zinziroge/ft601_evaboard/ft601_module.kicad_pcb

## KiCad design ft601_module.kicad_pcb (2026-03-01)

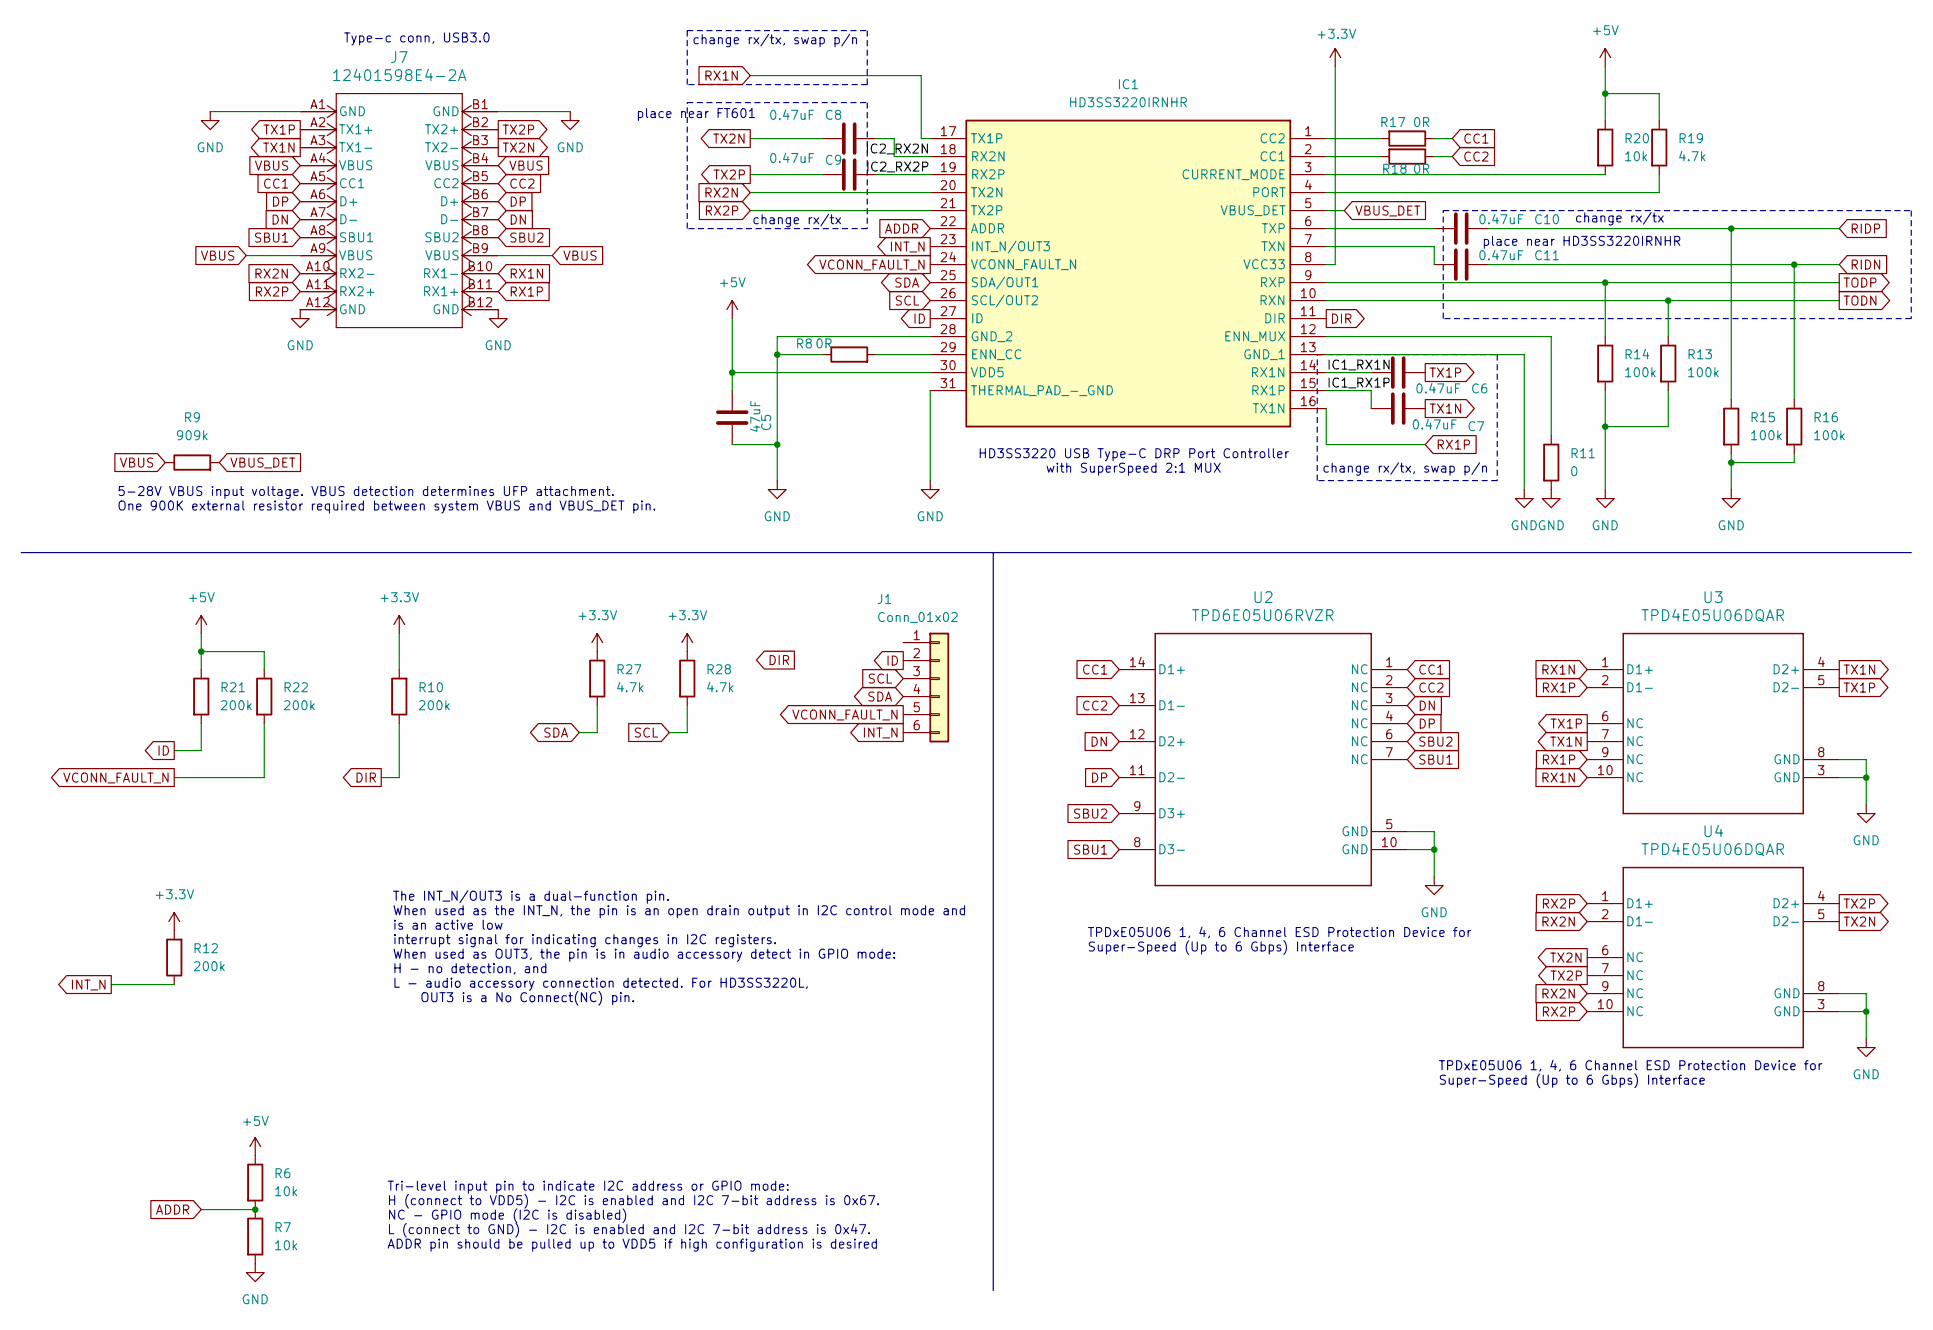
[picture p1: schematic usb3.0.kicad_sch]

Parts:
C5: 47uF; C_0603_1608Metric
C6, C7, C8, C9, C10, C11: 0.47uF; C_0402_1005Metric
IC1: HD3SS3220IRNHR; Manufacturer_Part_Number HD3SS3220IRNHR; Mouser Part Number 595-HD3SS3220IRNHR
J1: Conn_01x02; PinHeader_1x06_P2.54mm_Vertical
J7: 12401598E4-2A; CONN_12401598E4-2A_AMP
R6, R7, R20: 10k; R_0603_1608Metric
R8, R17, R18: 0R; R_0603_1608Metric
R9: 909k; R_0603_1608Metric
R10, R12, R21, R22: 200k; R_0603_1608Metric
R11: 0; R_0603_1608Metric
R13, R14, R15, R16: 100k; R_0603_1608Metric
R19, R27, R28: 4.7k; R_0603_1608Metric
U2: TPD6E05U06RVZR; RVZ0014A
U3, U4: TPD4E05U06DQAR; DQA0010A

Connections:
+3.3V: IC1.8 (VCC33), R10.2, R12.2, R27.1, R28.1; also elsewhere on the board
+5V: C5.1, IC1.30 (VDD5), R6.1, R19.1, R20.1, R21.1, R22.1; also elsewhere on the board
/usb3.0/IC1_RX1N: C6.2, IC1.14 (RX1N)
/usb3.0/IC1_RX1P: C7.2, IC1.15 (RX1P)
/usb3.0/IC2_RX2N: C8.1, IC1.18 (RX2N)
/usb3.0/IC2_RX2P: C9.1, IC1.19 (RX2P)
ADDR: IC1.22 (ADDR), R6.2, R7.1
CC1: J7.A5 (CC1), R17.1, U2.1 (NC), U2.14 (D1+)
CC2: J7.B5 (CC2), R18.1, U2.2 (NC), U2.13 (D1-)
DIR: IC1.11 (DIR), R10.1
DN: J7.A7 (D-), J7.B7 (D-), U2.3 (NC), U2.12 (D2+); also elsewhere on the board
DP: J7.A6 (D+), J7.B6 (D+), U2.4 (NC), U2.11 (D2-); also elsewhere on the board
GND: C5.2, IC1.13 (GND_1), IC1.28 (GND_2), IC1.31 (THERMAL_PAD_-_GND), J7.A1 (GND), J7.A12 (GND), J7.B1 (GND), J7.B12 (GND), R7.2, R8.1, R11.2, R13.2, R14.2, R15.2, R16.2, U2.5 (GND), U2.10 (GND), U3.3 (GND), U3.8 (GND), U4.3 (GND), U4.8 (GND); also elsewhere on the board
ID: IC1.27 (ID), J1.2, R21.2
INT_N: IC1.23 (INT_N/OUT3), J1.6, R12.1
unnamed: IC1.2 (CC1), R18.2
unnamed: IC1.1 (CC2), R17.2
unnamed: IC1.3 (CURRENT_MODE), R20.2
unnamed: IC1.29 (ENN_CC), R8.2
unnamed: IC1.12 (ENN_MUX), R11.1
unnamed: IC1.4 (PORT), R19.2
unnamed: C11.2, IC1.7 (TXN)
unnamed: C10.2, IC1.6 (TXP)
RIDN: C11.1, R16.1; also elsewhere on the board
RIDP: C10.1, R15.1; also elsewhere on the board
RX1N: IC1.17 (TX1P), J7.B10 (RX1-), U3.1 (D1+), U3.10 (NC)
RX1P: IC1.16 (TX1N), J7.B11 (RX1+), U3.2 (D1-), U3.9 (NC)
RX2N: IC1.20 (TX2N), J7.A10 (RX2-), U4.2 (D1-), U4.9 (NC)
RX2P: IC1.21 (TX2P), J7.A11 (RX2+), U4.1 (D1+), U4.10 (NC)
SBU1: J7.A8 (SBU1), U2.7 (NC), U2.8 (D3-)
SBU2: J7.B8 (SBU2), U2.6 (NC), U2.9 (D3+)
SCL: IC1.26 (SCL/OUT2), J1.3, R28.2
SDA: IC1.25 (SDA/OUT1), J1.4, R27.2
TODN: IC1.10 (RXN), R13.1; also elsewhere on the board
TODP: IC1.9 (RXP), R14.1; also elsewhere on the board
TX1N: C7.1, J7.A3 (TX1-), U3.4 (D2+), U3.7 (NC)
TX1P: C6.1, J7.A2 (TX1+), U3.5 (D2-), U3.6 (NC)
TX2N: C8.2, J7.B3 (TX2-), U4.5 (D2-), U4.6 (NC)
TX2P: C9.2, J7.B2 (TX2+), U4.4 (D2+), U4.7 (NC)
VBUS: J7.A4 (VBUS), J7.A9 (VBUS), J7.B4 (VBUS), J7.B9 (VBUS), R9.1; also elsewhere on the board
VBUS_DET: IC1.5 (VBUS_DET), R9.2
VCONN_FAULT_N: IC1.24 (VCONN_FAULT_N), J1.5, R22.2

Notes on the sheet:
place near FT601
HD3SS3220 USB Type-C DRP Port Controller with SuperSpeed 2:1 MUX
change rx/tx, swap p/n
5-28V VBUS input voltage. VBUS detection determines UFP attachment. One 900K external resistor required between system VBUS and VBUS_DET pin.
The INT_N/OUT3 is a dual-function pin. When used as the INT_N, the pin is an open drain output in I2C control mode and is an active low interrupt signal for indicating changes in I2C registers. When used as OUT3, the pin is in audio accessory detect in GPIO mode: H - no detection, and L - audio acc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
change rx/tx
TPDxE05U06 1, 4, 6 Channel ESD Protection Device for Super-Speed (Up to 6 Gbps) Interface
Tri-level input pin to indicate I2C address or GPIO mode: H (connect to VDD5) - I2C is enabled and I2C 7-bit address is 0x67. NC - GPIO mode (I2C is disabled) L (connect to GND) - I2C is enabled and I2C 7-bit address is 0x47. ADDR pin should be pulled up to VDD5 if high configuration is desired
Type-c conn, USB3.0
place near HD3SS3220IRNHR
TPDxE05U06 1, 4, 6 Channel ESD Protection Device for Super-Speed (Up to 6 Gbps) Interface

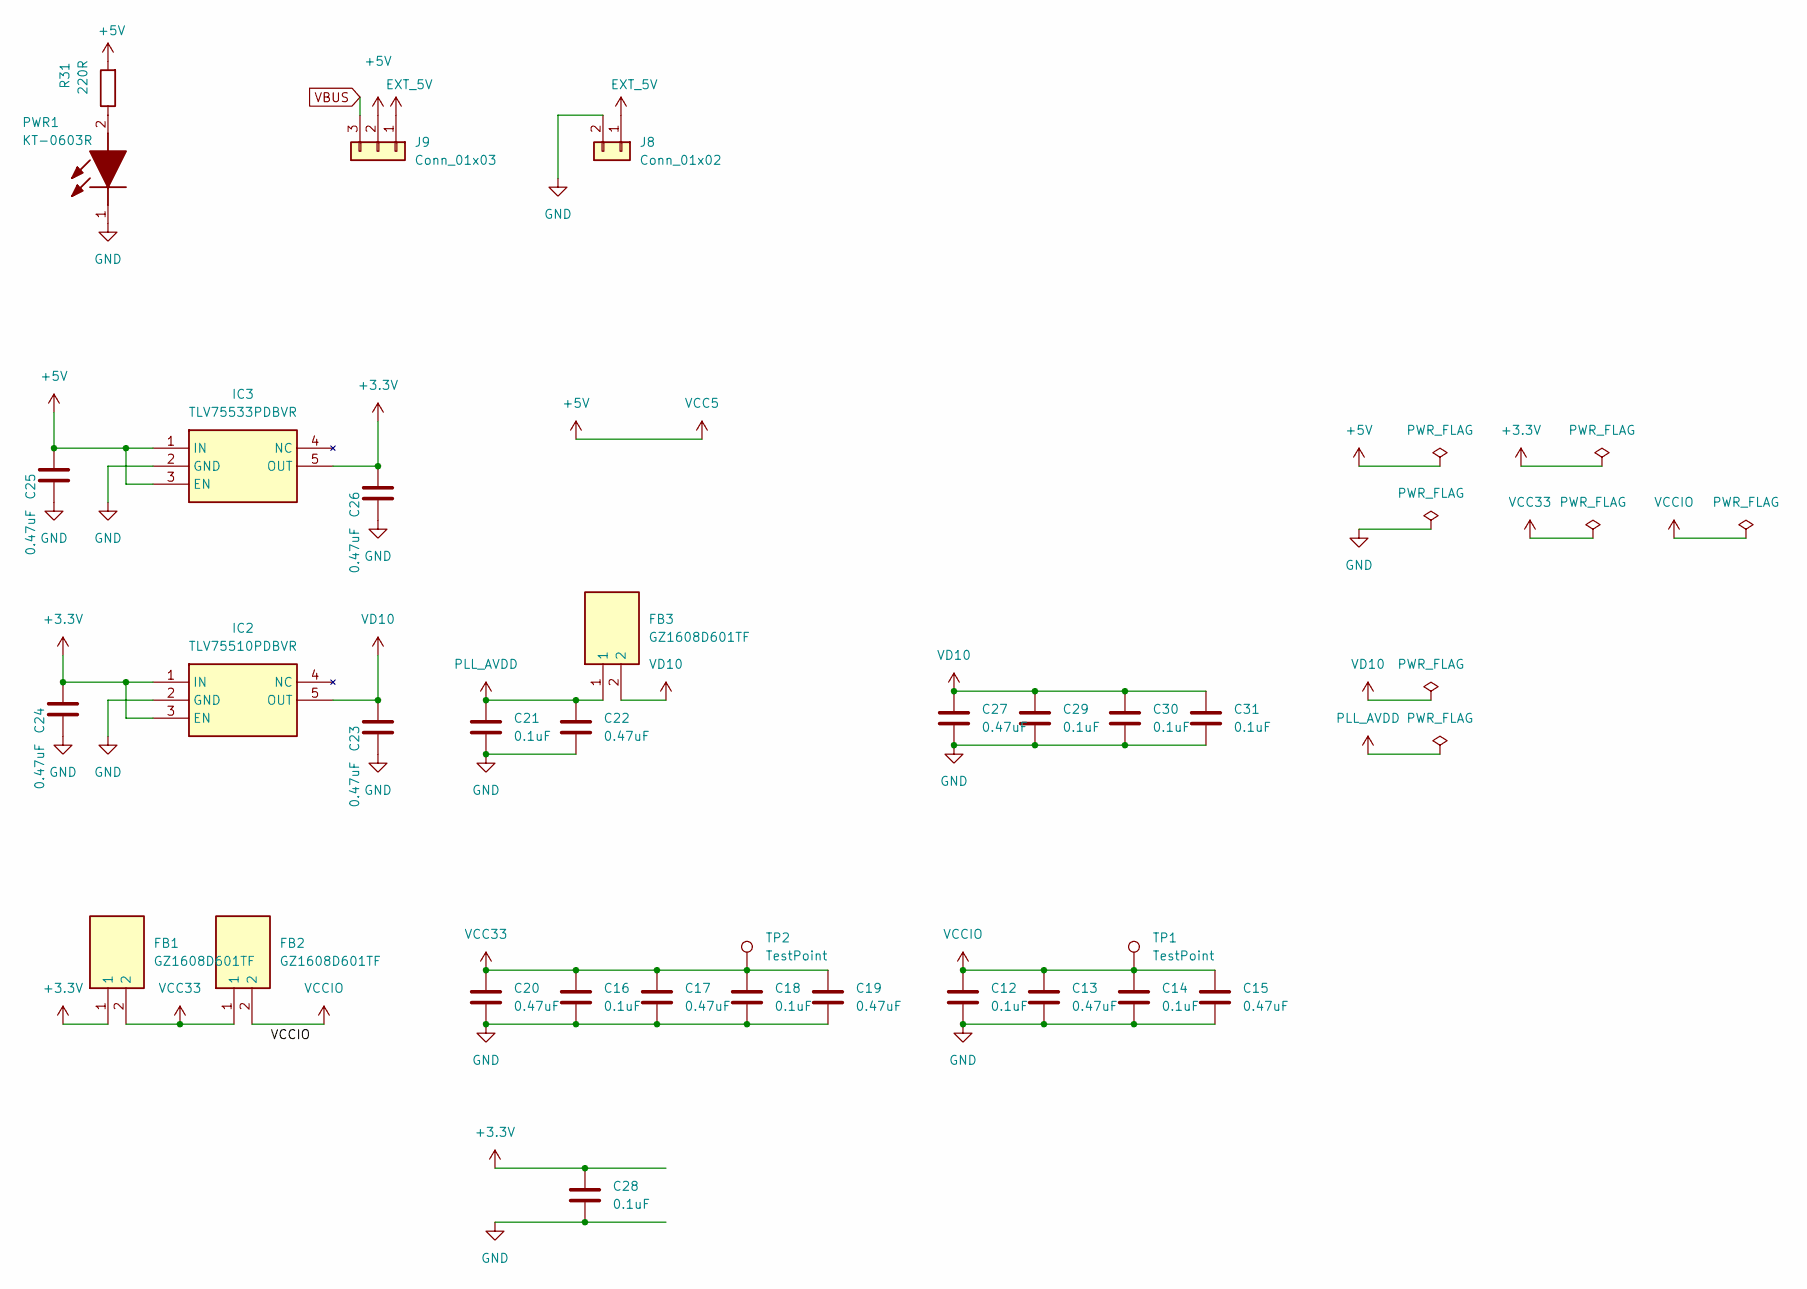
[picture p2: schematic power.kicad_sch]

Parts:
C12, C14, C16, C18, C21, C28, C29, C30, C31: 0.1uF; C_0603_1608Metric
C13, C15, C17, C19, C20, C22, C27: 0.47uF; C_0603_1608Metric
C23, C24, C25, C26: 0.47uF; C_0402_1005Metric
FB1, FB2, FB3: GZ1608D601TF; BEADC1608X95N; Manufacturer_Part_Number GZ1608D601TF
IC2: TLV75510PDBVR; SOT95P280X145-5N; Manufacturer_Part_Number TLV75510PDBVR; Mouser Part Number 595-TLV75510PDBVR
IC3: TLV75533PDBVR; SOT95P280X145-5N; Manufacturer_Part_Number TLV75533PDBVR; Mouser Part Number 595-TLV75533PDBVR
J8: Conn_01x02; PinHeader_1x02_P2.54mm_Vertical
J9: Conn_01x03; PinSocket_1x03_P2.54mm_Vertical
PWR1: KT-0603R; LEDC1608X70N; Manufacturer_Part_Number KT-0603R
R31: 220R; R_0603_1608Metric
TP1, TP2: TestPoint; TestPoint_Pad_D1.5mm

Connections:
+3.3V: C24.1, C26.1, C28.1, FB1.1, IC2.1 (IN), IC2.3 (EN), IC3.5 (OUT); also elsewhere on the board
+5V: C25.1, IC3.1 (IN), IC3.3 (EN), J9.2, R31.2; also elsewhere on the board
EXT_5V: J8.1, J9.1
GND: C12.2, C13.2, C14.2, C15.2, C16.2, C17.2, C18.2, C19.2, C20.2, C21.2, C22.2, C23.2, C24.2, C25.2, C26.2, C27.2, C28.2, C29.2, C30.2, C31.2, IC2.2 (GND), IC3.2 (GND), J8.2, PWR1.1 (K); also elsewhere on the board
unnamed: PWR1.2 (A), R31.1
PLL_AVDD: C21.1, C22.1, FB3.1; also elsewhere on the board
VBUS: J9.3; also elsewhere on the board
VCC33: C16.1, C17.1, C18.1, C19.1, C20.1, FB1.2, FB2.1, TP2.1; also elsewhere on the board
VCCIO: C12.1, C13.1, C14.1, C15.1, FB2.2, TP1.1; also elsewhere on the board
VD10: C23.1, C27.1, C29.1, C30.1, C31.1, FB3.2, IC2.5 (OUT); also elsewhere on the board

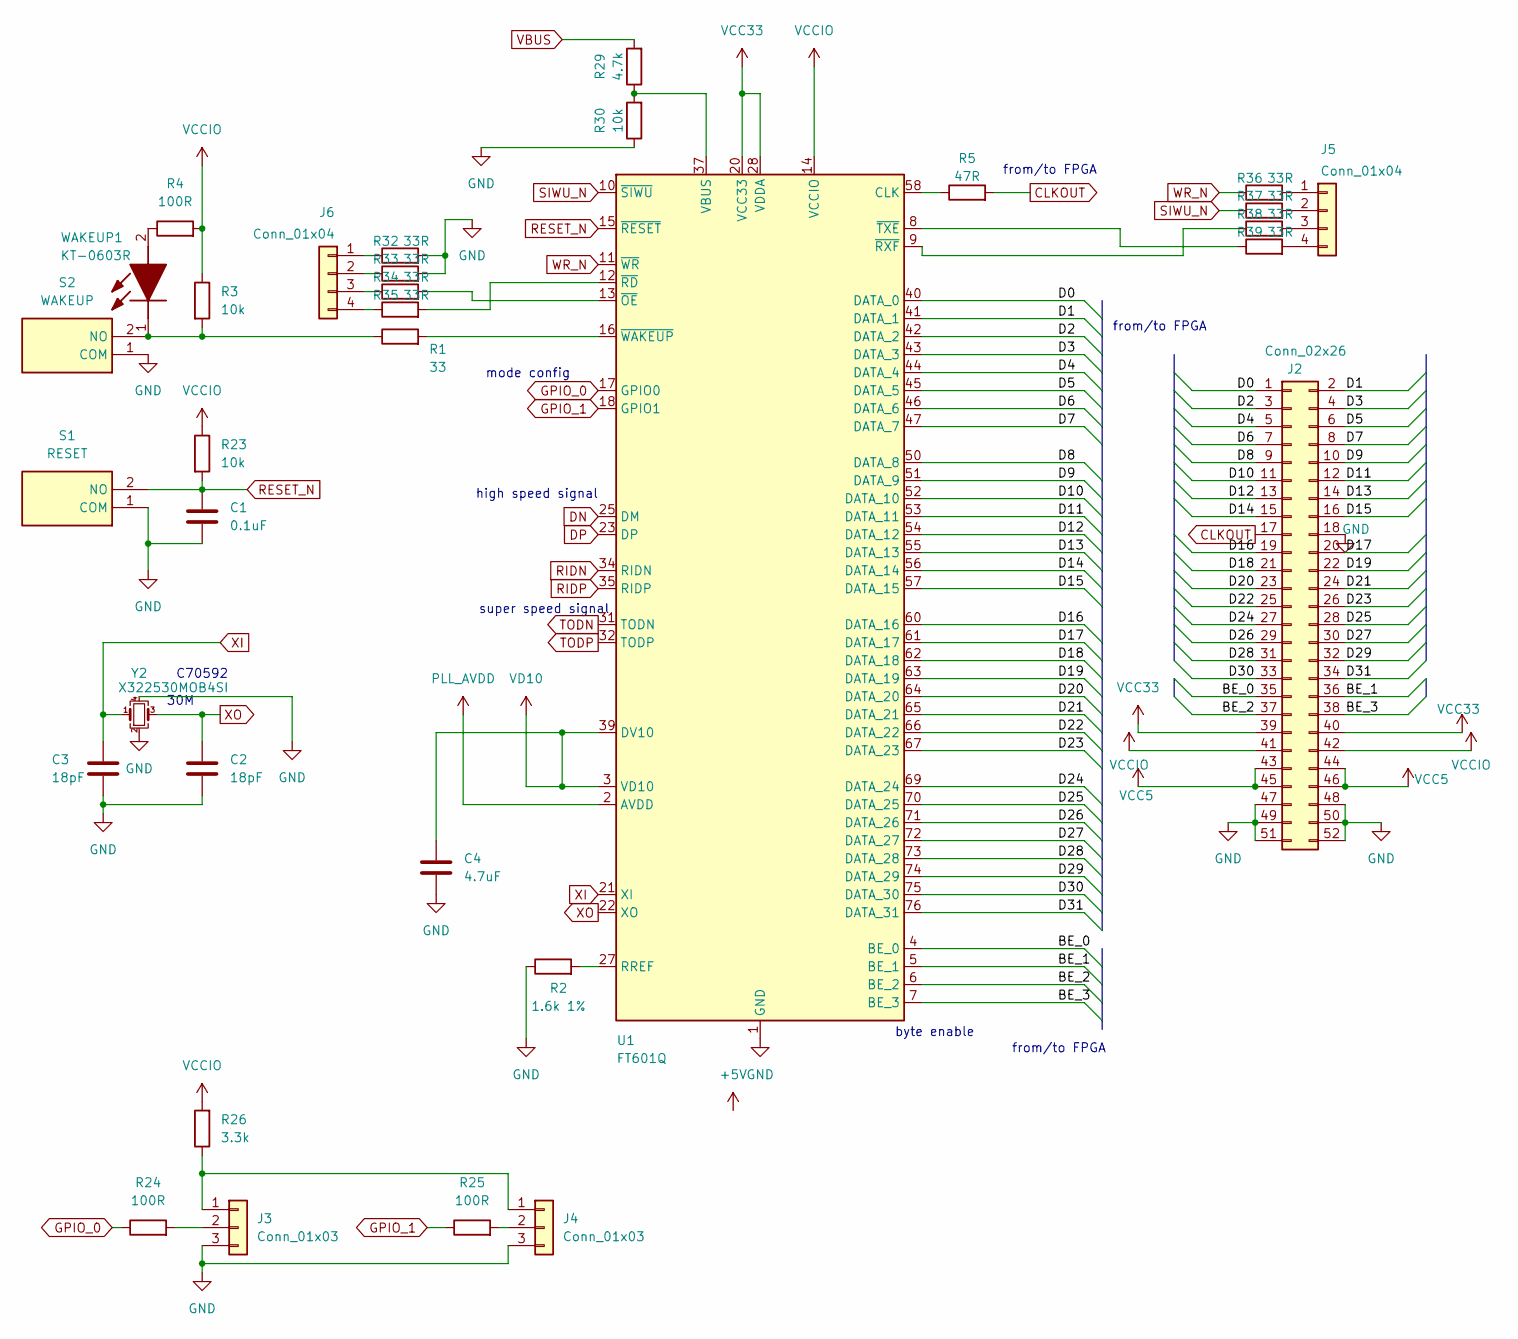
[picture p3: schematic ft601.kicad_sch]

Parts:
C1: 0.1uF; C_0603_1608Metric
C2, C3: 18pF; C_0603_1608Metric
C4: 4.7uF; C_0603_1608Metric
J2: Conn_02x26; PinSocket_2x26_P2.54mm_Vertical
J3, J4: Conn_01x03; PinHeader_1x03_P2.54mm_Vertical
J5, J6: Conn_01x04; PinHeader_1x04_P2.54mm_Vertical
R1: 33; R_0603_1608Metric
R2: 1.6k 1%; R_0603_1608Metric
R3, R23, R30: 10k; R_0603_1608Metric
R4, R24, R25: 100R; R_0603_1608Metric
R5: 47R; R_0603_1608Metric
R26: 3.3k; R_0603_1608Metric
R29: 4.7k; R_0603_1608Metric
R32, R33, R34, R35, R36, R37, R38, R39: 33R; R_0603_1608Metric
S1: RESET; TS1088AR02016; Manufacturer_Part_Number TS-1088-AR02016
S2: WAKEUP; TS1088AR02016; Manufacturer_Part_Number TS-1088-AR02016
U1: FT601Q; QFN-76-1EP_9x9mm_P0.4mm_EP5.81x6.31mm
WAKEUP1: KT-0603R; LEDC1608X70N; Manufacturer_Part_Number KT-0603R
Y2: X322530MOB4SI; Oscillator_SMD_YXC_X322530MOB4SI_SMD3225_4pin

Connections:
+5V: J2.43, J2.44, J2.45, J2.46; also elsewhere on the board
/ft601/BE_0: J2.35, U1.4 (BE_0)
/ft601/BE_1: J2.36, U1.5 (BE_1)
/ft601/BE_2: J2.37, U1.6 (BE_2)
/ft601/BE_3: J2.38, U1.7 (BE_3)
/ft601/D0: J2.1, U1.40 (DATA_0)
/ft601/D1: J2.2, U1.41 (DATA_1)
/ft601/D2: J2.3, U1.42 (DATA_2)
/ft601/D3: J2.4, U1.43 (DATA_3)
/ft601/D4: J2.5, U1.44 (DATA_4)
/ft601/D5: J2.6, U1.45 (DATA_5)
/ft601/D6: J2.7, U1.46 (DATA_6)
/ft601/D7: J2.8, U1.47 (DATA_7)
/ft601/D8: J2.9, U1.50 (DATA_8)
/ft601/D9: J2.10, U1.51 (DATA_9)
/ft601/D10: J2.11, U1.52 (DATA_10)
/ft601/D11: J2.12, U1.53 (DATA_11)
/ft601/D12: J2.13, U1.54 (DATA_12)
/ft601/D13: J2.14, U1.55 (DATA_13)
/ft601/D14: J2.15, U1.56 (DATA_14)
/ft601/D15: J2.16, U1.57 (DATA_15)
/ft601/D16: J2.19, U1.60 (DATA_16)
/ft601/D17: J2.20, U1.61 (DATA_17)
/ft601/D18: J2.21, U1.62 (DATA_18)
/ft601/D19: J2.22, U1.63 (DATA_19)
/ft601/D20: J2.23, U1.64 (DATA_20)
/ft601/D21: J2.24, U1.65 (DATA_21)
/ft601/D22: J2.25, U1.66 (DATA_22)
/ft601/D23: J2.26, U1.67 (DATA_23)
/ft601/D24: J2.27, U1.69 (DATA_24)
/ft601/D25: J2.28, U1.70 (DATA_25)
/ft601/D26: J2.29, U1.71 (DATA_26)
/ft601/D27: J2.30, U1.72 (DATA_27)
/ft601/D28: J2.31, U1.73 (DATA_28)
/ft601/D29: J2.32, U1.74 (DATA_29)
/ft601/D30: J2.33, U1.75 (DATA_30)
/ft601/D31: J2.34, U1.76 (DATA_31)
CLKOUT: J2.17, R5.2
DN: U1.25 (DM); also elsewhere on the board
DP: U1.23 (DP); also elsewhere on the board
GND: C1.2, C2.2, C3.2, C4.2, J2.18, J2.47, J2.48, J2.49, J2.50, J2.51, J2.52, J3.3, J4.3, R2.1, R30.1, R32.2, R33.2, S1.1 (COM), S2.1 (COM), U1.1 (GND), U1.26 (GND), U1.29 (GND), U1.36 (GND), U1.77 (GND), Y2.2, Y2.4; also elsewhere on the board
GPIO_0: R24.1, U1.17 (GPIO0)
GPIO_1: R25.1, U1.18 (GPIO1)
unnamed: J3.1, J4.1, R26.1
unnamed: J3.2, R24.2
unnamed: J4.2, R25.2
unnamed: J5.1, R36.2
unnamed: J5.2, R37.2
unnamed: J5.3, R38.2
unnamed: J5.4, R39.2
unnamed: J6.1, R32.1
unnamed: J6.2, R33.1
unnamed: J6.3, R34.1
unnamed: J6.4, R35.1
unnamed: R1.1, R3.2, S2.2 (NO), WAKEUP1.1 (K)
unnamed: R5.1, U1.58 (CLK)
unnamed: R2.2, U1.27 (RREF)
unnamed: R29.1, R30.2, U1.37 (VBUS)
unnamed: R34.2, U1.13 (~OE)
unnamed: R35.2, U1.12 (~RD)
unnamed: R38.1, U1.9 (~RXF)
unnamed: R39.1, U1.8 (~TXE)
unnamed: R1.2, U1.16 (~WAKEUP)
unnamed: R4.1, WAKEUP1.2 (A)
PLL_AVDD: U1.2 (AVDD); also elsewhere on the board
RESET_N: C1.1, R23.2, S1.2 (NO), U1.15 (~RESET)
RIDN: U1.34 (RIDN); also elsewhere on the board
RIDP: U1.35 (RIDP); also elsewhere on the board
SIWU_N: R37.1, U1.10 (~SIWU)
TODN: U1.31 (TODN); also elsewhere on the board
TODP: U1.32 (TODP); also elsewhere on the board
VBUS: R29.2; also elsewhere on the board
VCC33: J2.39, J2.40, U1.20 (VCC33), U1.24 (VCC33), U1.28 (VDDA), U1.38 (VCC33); also elsewhere on the board
VCCIO: J2.41, J2.42, R3.1, R4.2, R23.1, R26.2, U1.14 (VCCIO), U1.49 (VCCIO), U1.59 (VCCIO), U1.68 (VCCIO); also elsewhere on the board
VD10: C4.1, U1.3 (VD10), U1.30 (VD10), U1.33 (VD10), U1.39 (DV10), U1.48 (VD10); also elsewhere on the board
WR_N: R36.1, U1.11 (~WR)
XI: C3.1, U1.21 (XI), Y2.1
XO: C2.1, U1.22 (XO), Y2.3

Notes on the sheet:
C70592
from/to FPGA
super speed signal
30M
mode config
high speed signal
byte enable

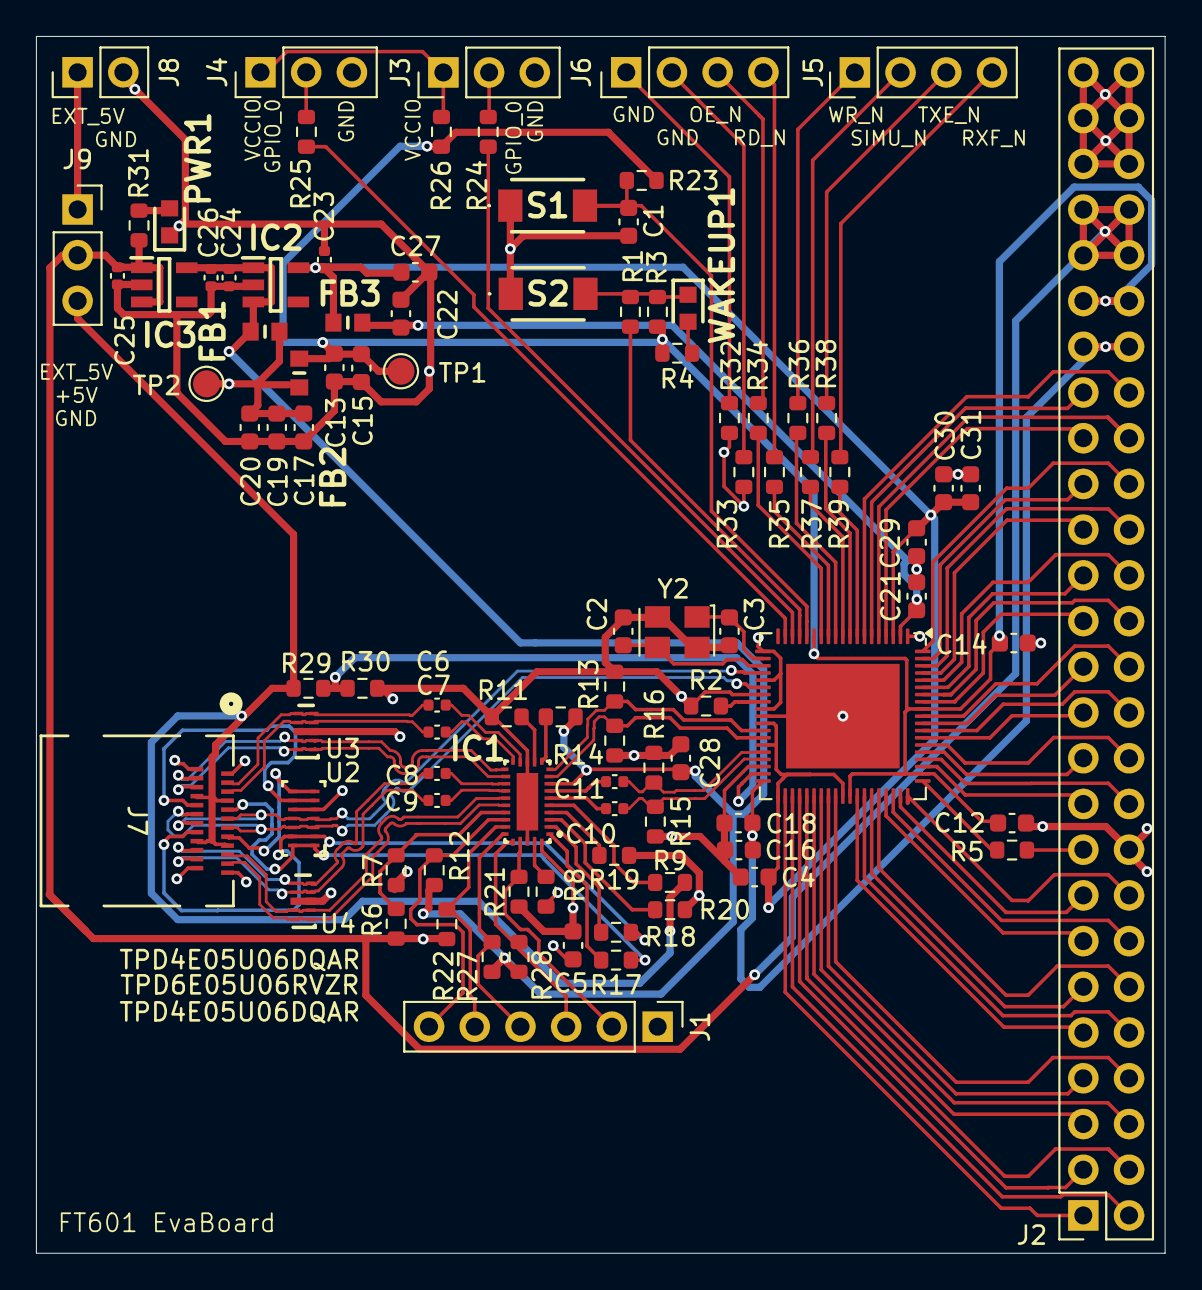
[picture p4: board ft601_module.kicad_pcb from above]

Board: 4 copper layers, 62.7 x 67.6 mm, 96 parts (0 on the bottom side), 113 nets.
